gsteiert/nfc-poker-chiptune/img/nfc-chip-jlcpcb.jpeg

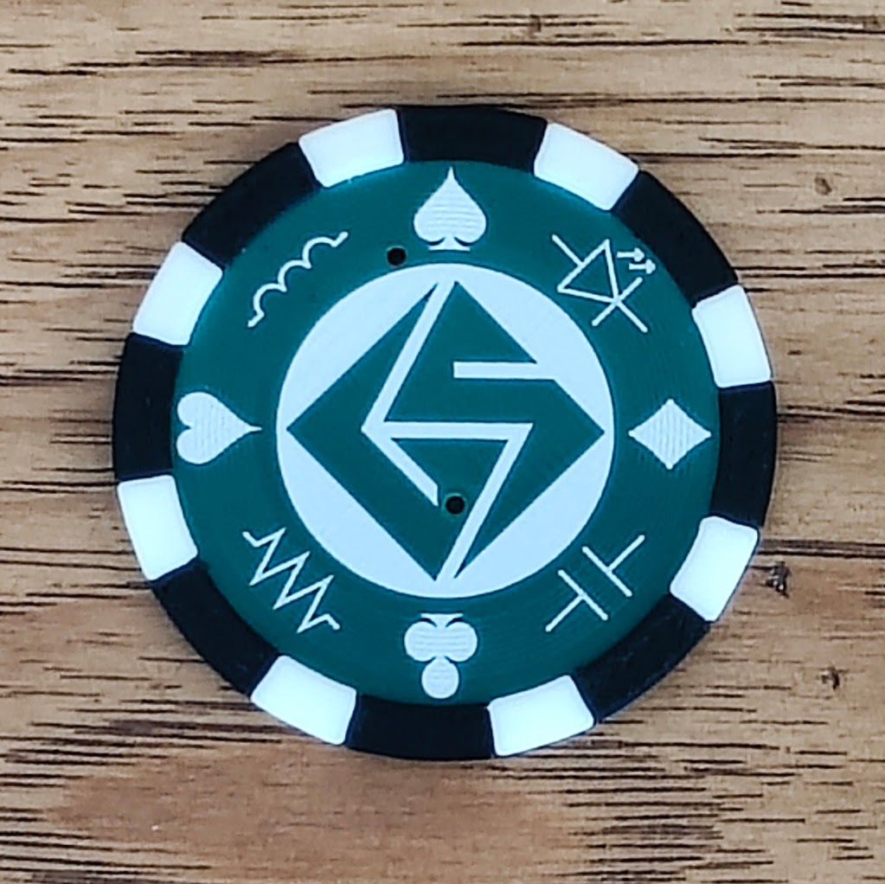
img/nfc-chip-jlcpcb.jpeg
