gsteiert/nfc-poker-chiptune/img/nfc-chip-oshpark.jpeg

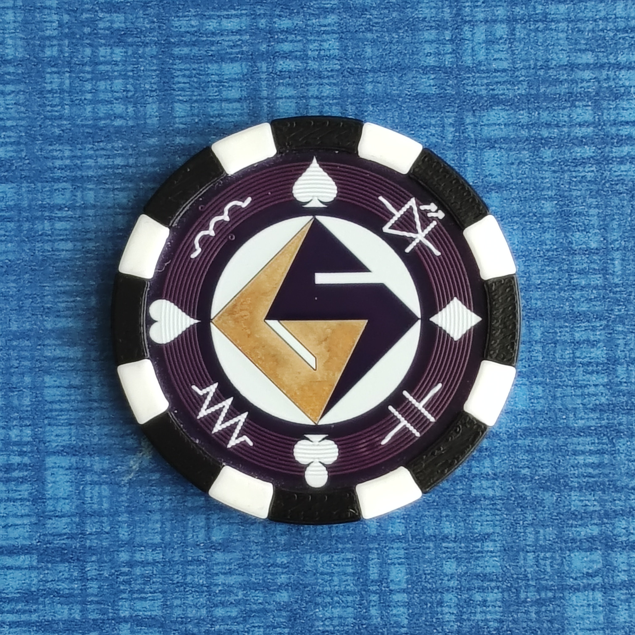
img/nfc-chip-oshpark.jpeg
