gsteiert/nfc-poker-chiptune/3d/poker-top.stl

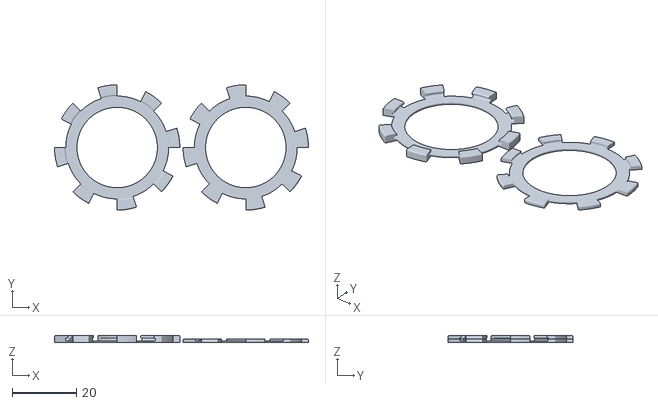
[picture p4: CAD file, 2026-11-07]
3d/poker-top.stl
79.0 x 39.0 x 2.20
