gsteiert/nfc-poker-chiptune/3d/poker-bot.stl

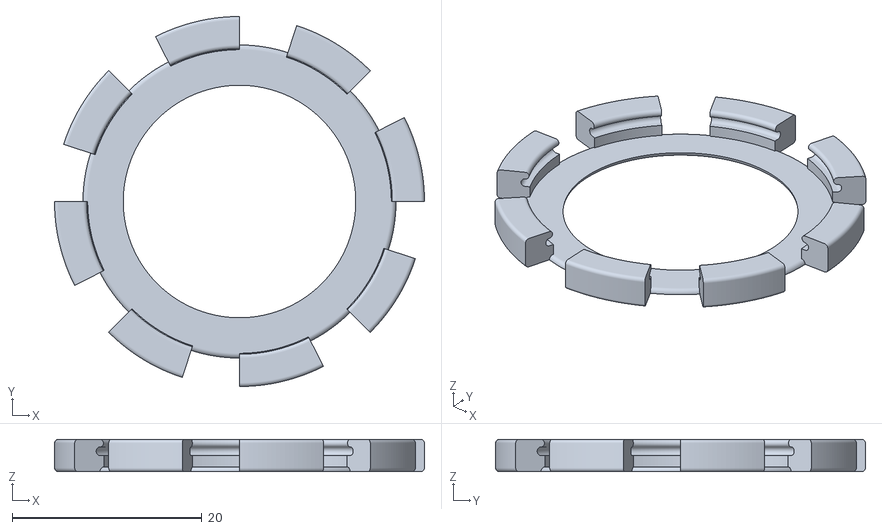
[picture p5: CAD file, 2026-11-07]
3d/poker-bot.stl
39.0 x 39.0 x 3.40
