gsteiert/nfc-poker-chiptune/pcb/nfc-coin.kicad_pcb

## KiCad design pcb/nfc-coin.kicad_pcb (2026-11-07)

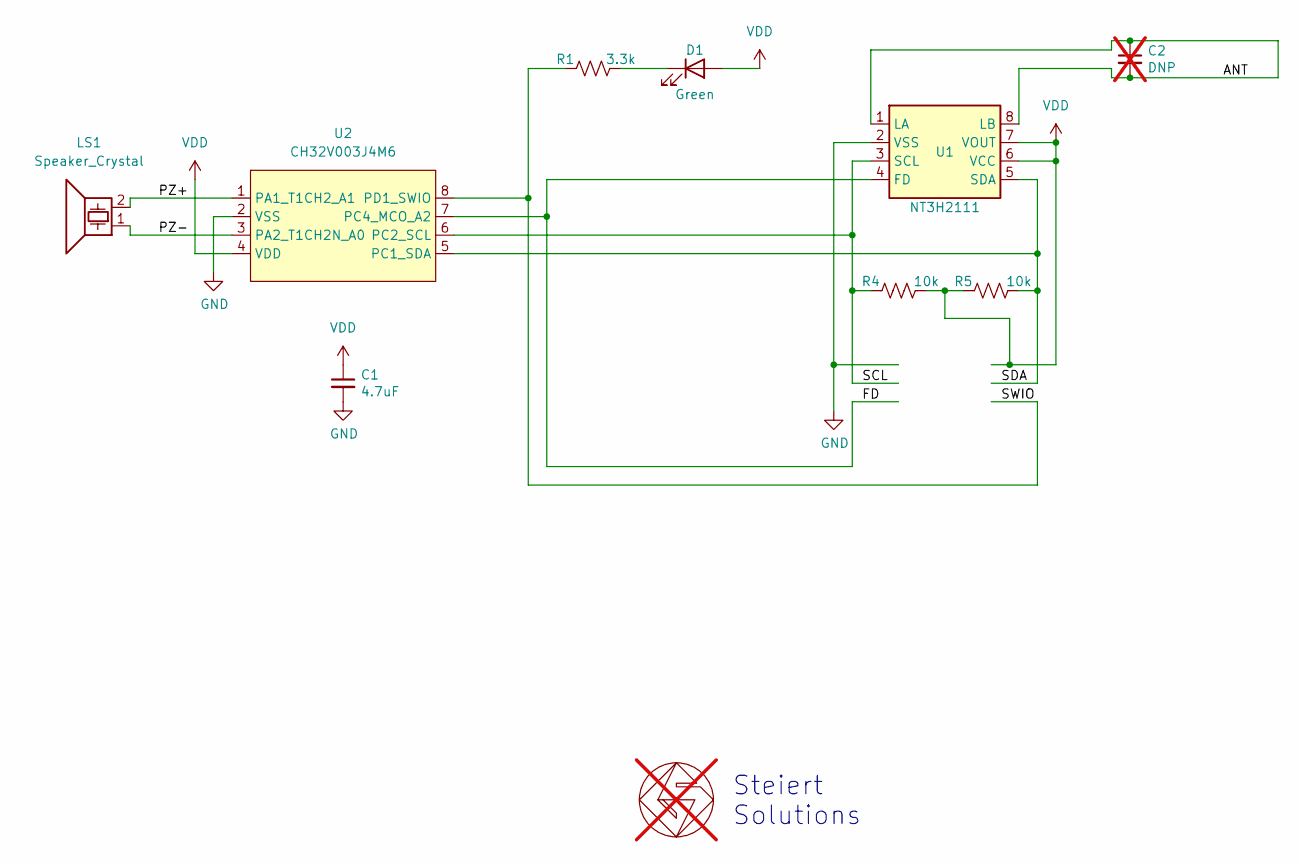
[picture p6: schematic nfc-coin.kicad_sch]

Parts:
C1: 4.7uF; C_0603_1608Metric_Pad1.08x0.95mm_HandSolder; MPN CL10A475KP8NNNC; LCSC C1705
C2: DNP; C_0603_1608Metric; not fitted
D1: Green; LED_0603_1608Metric_Pad1.05x0.95mm_HandSolder; MPN DYWH-19-21SUGC/4T; LCSC C47416536
GS1: GS_logo; gs_logo_200mil; not fitted
LS1: Speaker_Crystal; Buzzer_Mallory_AST1109MLTRQ; MPN FUET-1109; LCSC C391036
R1: 3.3k; R_0603_1608Metric_Pad0.98x0.95mm_HandSolder; MPN RC0603FR-073K3L; LCSC C108078
R4, R5: 10k; R_0603_1608Metric_Pad0.98x0.95mm_HandSolder; MPN RC0603FR-0710KL; LCSC C98220
U1: NT3H2111; SO-8_3.9x4.9mm_P1.27mm; MPN NT3H2111W0FT1X; LCSC C2654859
U2: CH32V003J4M6; SO-8_3.9x4.9mm_P1.27mm; MPN CH32V003J4M6; LCSC C5346354

Connections:
/ANT: C2.1, C2.2, U1.1 (LA), U1.8 (LB)
/FD: U1.4 (FD), U2.7 (PC4_MCO_A2)
/PZ+: LS1.2, U2.1 (PA1_T1CH2_A1)
/PZ-: LS1.1, U2.3 (PA2_T1CH2N_A0)
/SCL: R4.2, U1.3 (SCL), U2.6 (PC2_SCL)
/SDA: R5.1, U1.5 (SDA), U2.5 (PC1_SDA)
/SWIO: R1.2, U2.8 (PD1_SWIO)
GND: C1.2, U1.2 (VSS), U2.2 (VSS)
unnamed: D1.1 (K), R1.1
VDD: C1.1, D1.2 (A), R4.1, R5.2, U1.6 (VCC), U1.7 (VOUT), U2.4 (VDD)

Notes on the sheet:
Steiert Solutions

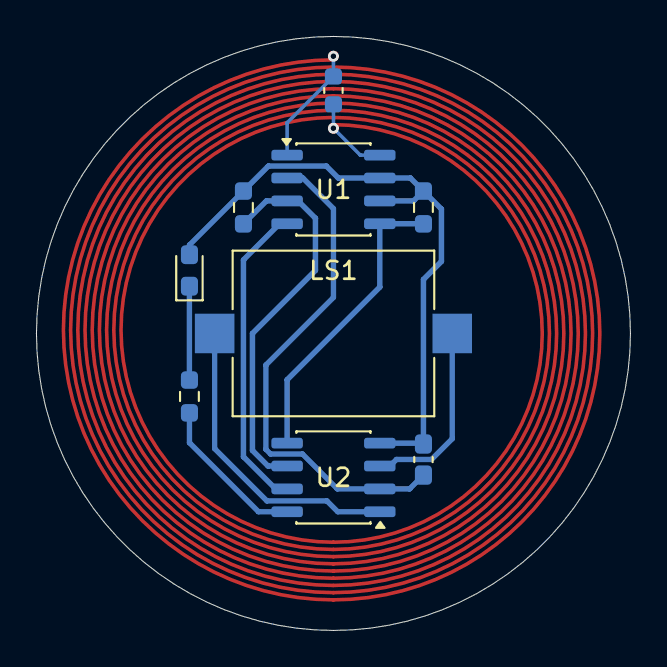
[picture p7: board nfc-coin.kicad_pcb from below]

Board: 2 copper layers, 33.0 x 33.0 mm, 9 parts (9 on the bottom side), 10 nets.
